YoungOneOne/Portable-Circuit-Tester/Docs/电路原理图.pdf

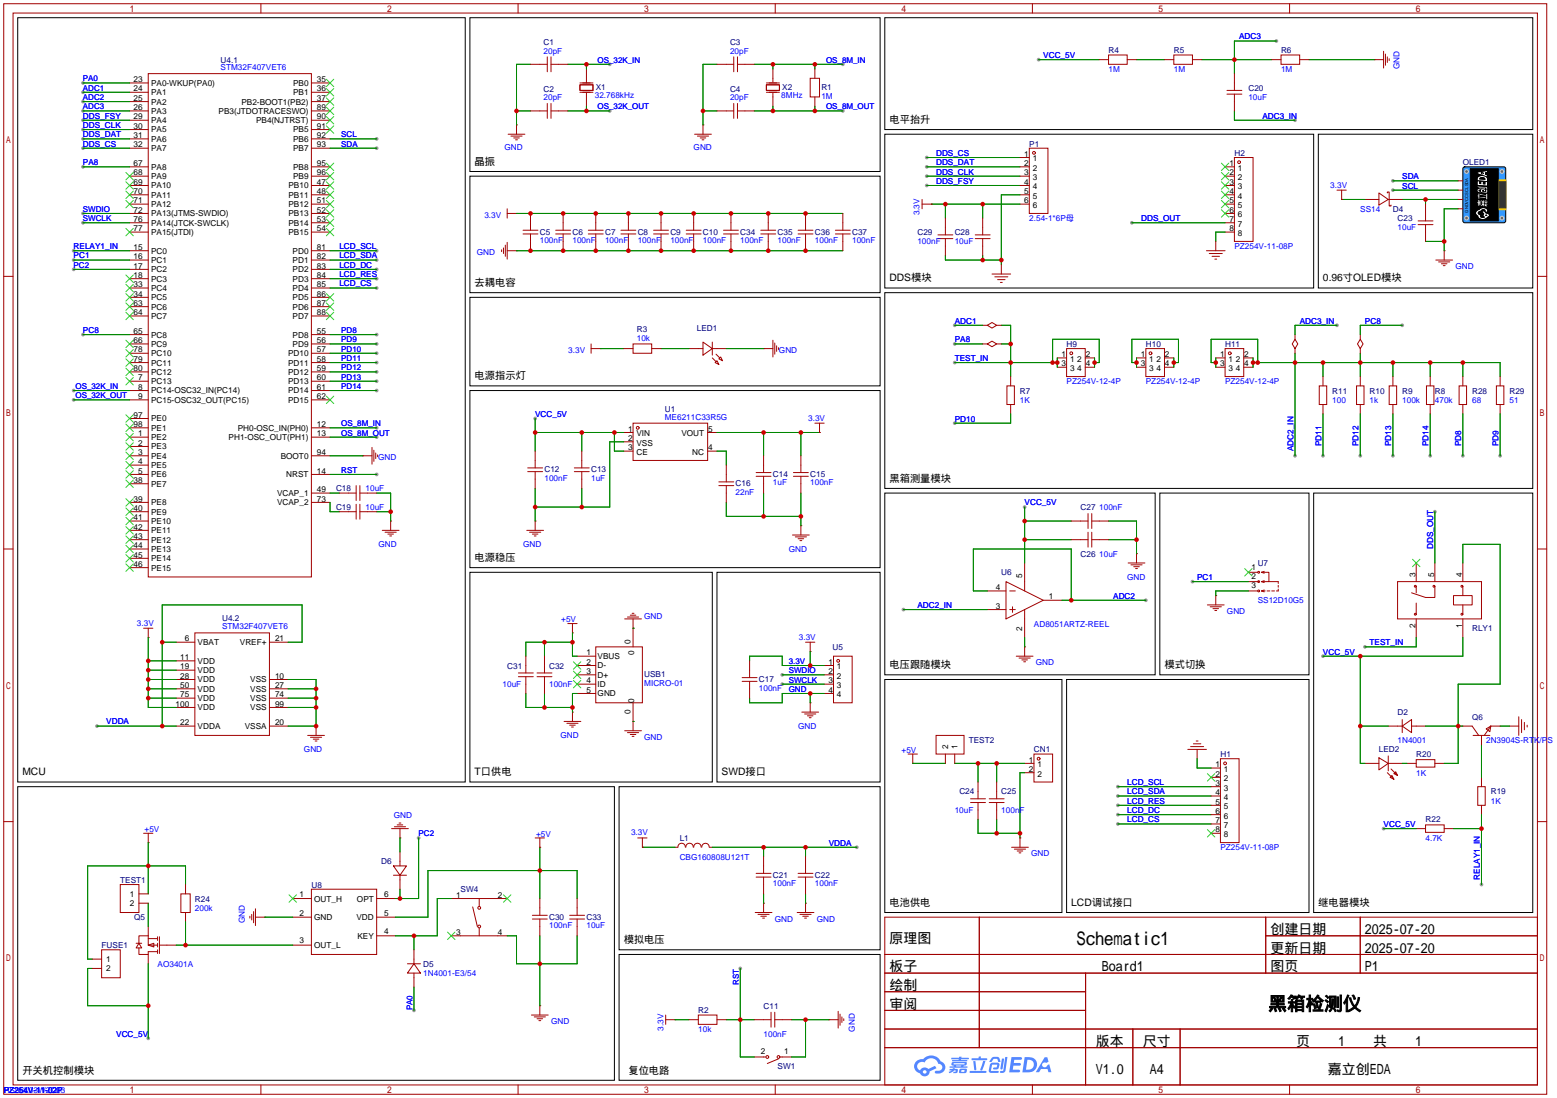
[picture p2: page 1]

原理图 | Schematic1 | 创建日期 | 2025-07-20

更新日期 | 2025-07-20

板子 | Board1 | 图页 | P1
绘制 | | 黑箱检测仪
审阅

V1.0 | A4 | 嘉立创EDA
