YoungOneOne/Portable-Circuit-Tester/Docs/面板.pdf

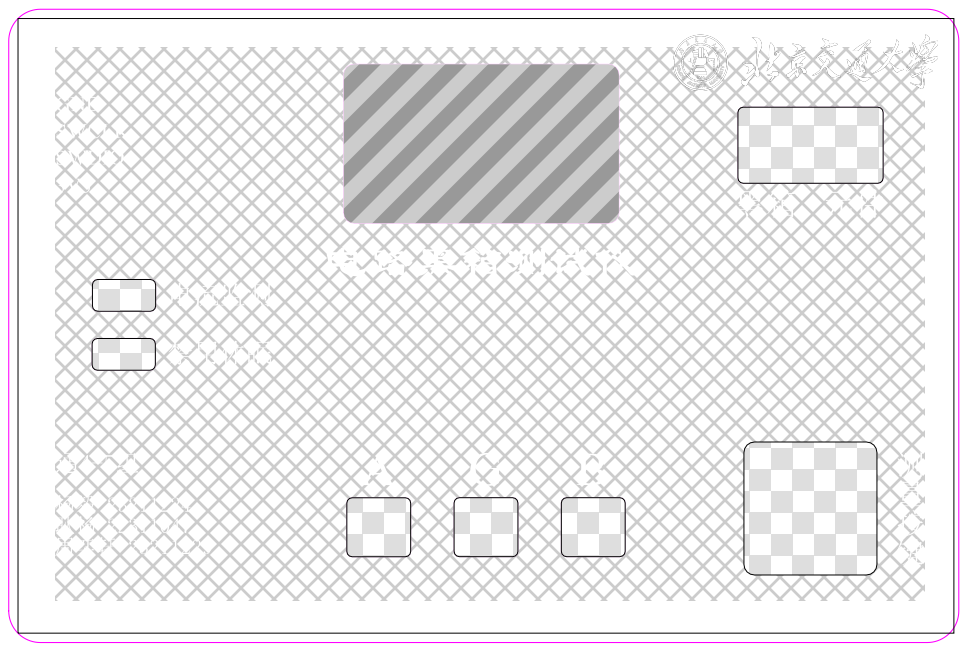
[picture p3: page 1]
