YoungOneOne/Portable-Circuit-Tester/(list of files, drawings)

Other design files:
Simulation/RC RL串联.ms14
Simulation/低功耗&开关(1).ms14
Simulation/提高 电阻接地 C .ms14
Simulation/提高 电阻接地 L.ms14
Simulation/提高 黑箱接地 C .ms14
Simulation/提高 黑箱接地 L.ms14
Simulation/电路仿真（频域）.ms14
