YoungOneOne/Portable-Circuit-Tester/Firmware/Black Box/Hardware/Inc/Picture.h

const unsigned char gImage_123[40960] = { /* 0X91,0X10,0X00,0XA0,0X00,0X80,0X01,0X1B, */
0XA4,0X6B,0XA4,0X6B,0XA4,0X6C,0XA4,0X6C,0XA4,0X6C,0XA4,0X6C,0XA4,0X6B,0XA4,0X6B,
0XA4,0X6B,0XA4,0X6B,0XA4,0X6B,0XA4,0X6B,0XA4,0X6B,0XA4,0X6B,0XA4,0X6B,0XA4,0X6B,
0XA4,0X6B,0X93,0XA9,0X62,0X05,0X39,0X03,0X30,0XC3,0X28,0XA3,0X20,0X83,0X20,0XA3,
0X20,0X83,0X20,0X83,0X20,0X83,0X18,0X83,0X18,0X63,0X10,0X63,0X08,0X63,0X08,0X43,
0X08,0X43,0X00,0X43,0X00,0X43,0X00,0X43,0X00,0X43,0X10,0X63,0X10,0X63,0X18,0X83,
0X18,0X63,0X18,0X83,0X18,0X83,0X18,0X63,0X18,0X83,0X10,0X63,0X10,0X63,0X10,0X83,
0X10,0X83,0X18,0X83,0X20,0XA3,0X20,0XA3,0X28,0XC4,0X30,0XC4,0X30,0XE4,0X39,0X04,
0X39,0X04,0X39,0X04,0X39,0X04,0X39,0X04,0X39,0X04,0X39,0X04,0X41,0X24,0X41,0X24,
0X41,0X04,0X38,0XE4,0X38,0XE4,0X30,0XC4,0X30,0XC3,0X28,0XA4,0X28,0XA4,0X20,0XC3,
0X18,0X83,0X39,0X45,0XEE,0X35,0XFE,0XB7,0XF6,0X97,0XF6,0X55,0XDC,0XAD,0XDD,0X31,
0XFF,0X19,0XFE,0XF8,0XFE,0XF9,0XFF,0X19,0XFF,0X19,0XFE,0XF9,0XF6,0XD8,0XF6,0XB7,
0XEE,0X76,0XEE,0X13,0XD4,0X8B,0X30,0XC3,0X00,0X02,0X39,0X24,0XD5,0X0C,0XEE,0X0E,
0XE5,0X8C,0XE5,0X6B,0XE5,0X8B,0XE5,0X8C,0XE5,0X6B,0XE5,0X4A,0XED,0X8B,0XB4,0X28,
0X9B,0XCA,0XF6,0X70,0XE6,0X0F,0XE5,0XEE,0XE5,0XEE,0XE5,0XEF,0XEE,0X0F,0XE5,0XEE,
0X7A,0XA7,0XCD,0X0C,0XE5,0XCE,0XE5,0XEF,0XE6,0X0F,0XEE,0X30,0XEE,0X30,0XEE,0X30,
0XE5,0XEF,0X82,0XE8,0XDD,0XF2,0XF6,0XF6,0XEE,0XD5,0XEE,0XD5,0XEE,0XD5,0XF6,0XD6,
0XA4,0X6B,0XA4,0X6C,0XA4,0X6B,0XA4,0X6B,0XA4,0X6C,0XA4,0X6C,0XA4,0X6C,0XA4,0X6C,
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
0X8C,0XD1,0X94,0XD1,0X94,0XF2,0X95,0X12,0X95,0X13,0X9D,0X33,0X9D,0X33,0X9D,0X12,
0X9D,0X12,0X94,0XD1,0X94,0XB0,0X8C,0X2E,0X83,0XAB,0X7B,0X28,0X72,0XC6,0X72,0XA6,
0X7A,0XE6,0X83,0X06,0X83,0X27,0X8B,0X47,0X8B,0X47,0X8B,0X46,0X83,0X46,0X83,0X46,
0X83,0X26,0X83,0X26,0X9C,0X2A,0XCD,0XB1,0XDE,0X76,0XE6,0XB7,0XE6,0X75,0XCD,0X50,
0X9B,0X29,0X82,0X67,0X9B,0X89,0XB4,0X6B,0XB4,0X6B,0X9B,0XA8,0X8B,0X07,0X92,0XE7,
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
