YoungOneOne/Portable-Circuit-Tester/Firmware/Black Box/Hardware/Inc/Picture2.h

const unsigned char gImage_fjx[24576] = { /* 0X50,0X10,0X00,0X80,0X00,0X60,0X01,0X1B, */
0X3A,0X07,0X3A,0X05,0X31,0XE4,0X4A,0X84,0X31,0XC3,0X29,0XA3,0X29,0X84,0X29,0XA4,
0X29,0X84,0X29,0X83,0X21,0X21,0X31,0XE5,0X29,0X64,0X31,0XC4,0X31,0XC5,0X29,0X64,
0X3A,0X05,0X4A,0X86,0X3A,0X05,0X29,0XC5,0X29,0XA4,0X29,0X64,0X3A,0X04,0X21,0X23,
0X31,0XE6,0X32,0X05,0X3A,0X26,0X29,0XA4,0X3A,0X24,0X42,0X65,0X29,0XA2,0X53,0X07,
0X29,0XA3,0X32,0X24,0X3A,0X64,0X42,0XC3,0X42,0X85,0X42,0X65,0X4A,0XA6,0X29,0XA3,
0X21,0X63,0X29,0X83,0X4A,0XE6,0X32,0X04,0X3A,0X25,0X29,0X84,0X32,0X04,0X19,0X23,
0X19,0X03,0X21,0X23,0X42,0X46,0X19,0X03,0X29,0X84,0X21,0X24,0X21,0X24,0X29,0XE3,
0X31,0XE3,0X3A,0X46,0X4A,0XA7,0X29,0XC4,0X21,0X44,0X31,0XE5,0X31,0XE5,0X31,0XA5,
0X29,0X85,0X29,0XA5,0X21,0X64,0X19,0X03,0X3A,0X05,0X3A,0X04,0X4A,0XA6,0X21,0X23,
0X19,0X23,0X31,0XC4,0X42,0X66,0X52,0XE6,0X3A,0X25,0X31,0XC4,0X21,0X23,0X4A,0X65,
0X3A,0X24,0X42,0X47,0X29,0X84,0X18,0XE3,0X31,0XC5,0X42,0X67,0X19,0X03,0X19,0X03,
0X29,0XA5,0X31,0XE5,0X29,0X84,0X21,0X24,0X18,0XE3,0X21,0X44,0X19,0X03,0X18,0XC3,
0X29,0XA5,0X18,0XE3,0X18,0XE3,0X21,0X44,0X19,0X03,0X19,0X03,0X21,0X44,0X3A,0X05,
0X3A,0X66,0X84,0X8C,0X42,0X84,0X3A,0X44,0X31,0XE4,0X53,0X07,0X42,0X45,0X52,0XE7,
0X4A,0X85,0X42,0X25,0X18,0XE3,0X18,0XE3,0X18,0XC2,0X29,0X65,0X52,0XE9,0X29,0X84,
0X21,0X64,0X29,0X84,0X29,0X64,0X52,0XE8,0X52,0XE5,0X42,0X65,0X52,0XC7,0X5A,0XC9,
0X39,0XE3,0X21,0X03,0X29,0XC3,0X21,0X42,0X39,0XE4,0X29,0X83,0X29,0XA3,0X3A,0X03,
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
0XDE,0XBA,0XDE,0XBA,0XDE,0XBA,0XD6,0X9A,0XD6,0XBA,0XDE,0XBA,0XDE,0XBA,0XD6,0XBA,
0XD6,0XBA,0XD6,0XBA,0XD6,0XBA,0XD6,0XBA,0XD6,0XBA,0XD6,0XBA,0XD6,0X9A,0XD6,0XBA,
0XD6,0XBA,0XD6,0XBA,0XD6,0XBA,0XD6,0XBA,0XD6,0X9A,0XD6,0XBA,0XD6,0XBA,0XD6,0X9A,
0XD6,0XBA,0XD6,0XBA,0XD6,0X9A,0XD6,0XBA,0XD6,0X9A,0XD6,0X9A,0XD6,0XBA,0XD6,0XBA,
0XD6,0X9A,0XD6,0X9A,0XD6,0X9A,0XD6,0X9A,0XD6,0XBA,0XD6,0X9A,0XD6,0X9A,0XD6,0X9A,
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
