YoungOneOne/Portable-Circuit-Tester/Firmware/Black Box/Hardware/Inc/oled.h

#ifndef __OLED_H__
#define __OLED_H__

#include "font96.h"
#include "main.h"
#include "string.h"

#define OLED_PAGE 8            // OLED椤垫暟
#define OLED_ROW 8 * OLED_PAGE // OLED琛屾暟
#define OLED_COLUMN 128        // OLED鍒楁暟

typedef enum {
  OLED_COLOR_NORMAL = 0, // 姝ｅ父妯″紡 榛戝簳鐧藉瓧
  OLED_COLOR_REVERSED    // 鍙嶈壊妯″紡 鐧藉簳榛戝瓧
} OLED_ColorMode;

void OLED_Init();
void OLED_DisPlay_On();
void OLED_DisPlay_Off();

void OLED_NewFrame();
void OLED_ShowFrame();
void OLED_SetPixel(uint8_t x, uint8_t y, OLED_ColorMode color);

void OLED_DrawLine(uint8_t x1, uint8_t y1, uint8_t x2, uint8_t y2, OLED_ColorMode color);
void OLED_DrawRectangle(uint8_t x, uint8_t y, uint8_t w, uint8_t h, OLED_ColorMode color);
void OLED_DrawFilledRectangle(uint8_t x, uint8_t y, uint8_t w, uint8_t h, OLED_ColorMode color);
void OLED_DrawTriangle(uint8_t x1, uint8_t y1, uint8_t x2, uint8_t y2, uint8_t x3, uint8_t y3, OLED_ColorMode color);
void OLED_DrawFilledTriangle(uint8_t x1, uint8_t y1, uint8_t x2, uint8_t y2, uint8_t x3, uint8_t y3, OLED_ColorMode color);
void OLED_DrawCircle(uint8_t x, uint8_t y, uint8_t r, OLED_ColorMode color);
void OLED_DrawFilledCircle(uint8_t x, uint8_t y, uint8_t r, OLED_ColorMode color);
void OLED_DrawEllipse(uint8_t x, uint8_t y, uint8_t a, uint8_t b, OLED_ColorMode color);
void OLED_DrawImage(uint8_t x, uint8_t y, const Image *img, OLED_ColorMode color);

void OLED_PrintASCIIChar(uint8_t x, uint8_t y, char ch, const ASCIIFont *font, OLED_ColorMode color);
void OLED_PrintASCIIString(uint8_t x, uint8_t y, char *str, const ASCIIFont *font, OLED_ColorMode color);
void OLED_PrintString(uint8_t x, uint8_t y, char *str, const Font *font, OLED_ColorMode color);

#endif // __OLED_H__
