YoungOneOne/Portable-Circuit-Tester/Firmware/Black Box/Hardware/Inc/gui.h

#include "stm32f4xx_hal.h"


uint16_t LCD_BGR2RGB(uint16_t c);
void Gui_Circle(uint16_t X,uint16_t Y,uint16_t R,uint16_t fc);  
void Gui_DrawLine(uint16_t x0, uint16_t y0,uint16_t x1, uint16_t y1,uint16_t Color);  
void Gui_DrawDashedLine(uint16_t x0, uint16_t y0, uint16_t x1, uint16_t y1, uint16_t Color, uint8_t dash_length, uint8_t gap_length);
void Gui_box(uint16_t x, uint16_t y, uint16_t w, uint16_t h,uint16_t bc);
void Gui_box2(uint16_t x,uint16_t y,uint16_t w,uint16_t h, uint8_t mode);
void DisplayButtonDown(uint16_t x1,uint16_t y1,uint16_t x2,uint16_t y2);
void DisplayButtonUp(uint16_t x1,uint16_t y1,uint16_t x2,uint16_t y2);
void Gui_DrawFont_GBK16(uint16_t x, uint16_t y, uint16_t fc, uint16_t bc, unsigned char *s);
void Gui_DrawFont_GBK24(uint16_t x, uint16_t y, uint16_t fc, uint16_t bc, unsigned char *s);
void Gui_DrawFont_Num32(uint16_t x, uint16_t y, uint16_t fc, uint16_t bc, uint16_t num) ;


void Test_Demo(void);	//液晶屏测试例程
